doesntfazer/CrowBoard/README.md

# Crowboard
crowboard
 Single Board 34/36 Key Keyboard

Check out [Docs](https://github.com/doesntfazer/CrowBoard/tree/main/Docs) for build instructions
