doesntfazer/CrowBoard/Crowboard-Kicad-rev1 - MX - Kailh-hotswap/README.md

# Crowboard Rev1 MX
This board is tested and working
Crowboard MX
