doesntfazer/CrowBoard/Crowboard-Kicad-rev2 MX/README.md

# Crowboard Rev 2

This board isn't tested. Choc only. In theory everything should work, and the [firmware](https://github.com/doesntfazer/Keyboard-Dweebs-Firmware-repository/tree/main/KMK/CrowBoard) is made to support this board.
