doesntfazer/CrowBoard/DXF/topplate.dxf

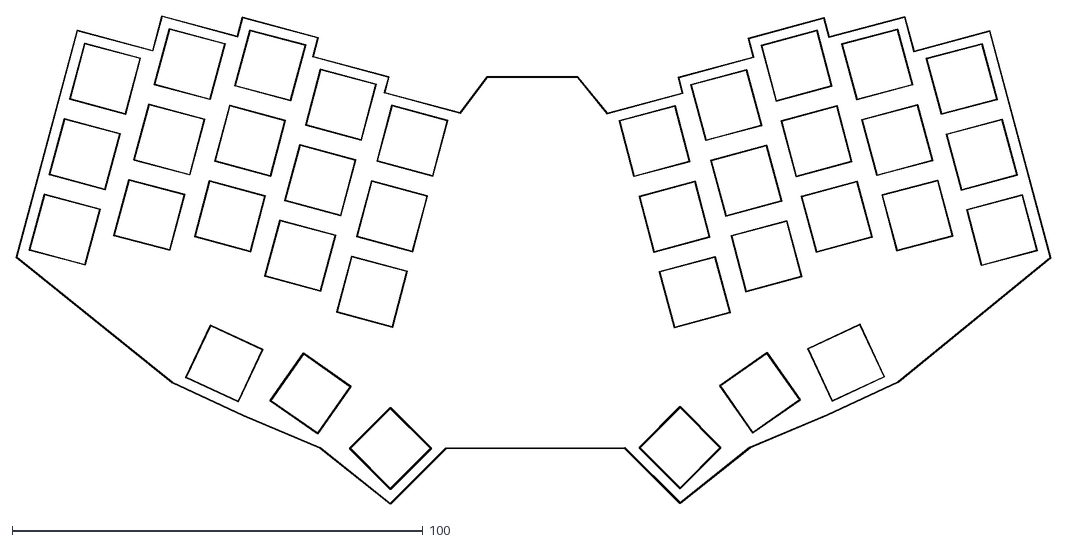
[picture p1: CAD file, 2022-05-02]
DXF/topplate.dxf
251.9 x 118.9
