doesntfazer/CrowBoard/DXF/case_BottomPlate.dxf

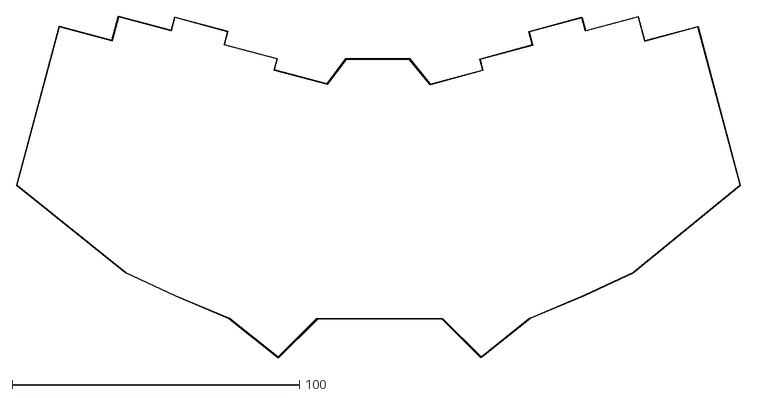
[picture p2: CAD file, 2022-05-02]
DXF/case_BottomPlate.dxf
251.9 x 118.9
