doesntfazer/CrowBoard/Case/Crowboard Bottom - friction - no screws.stl

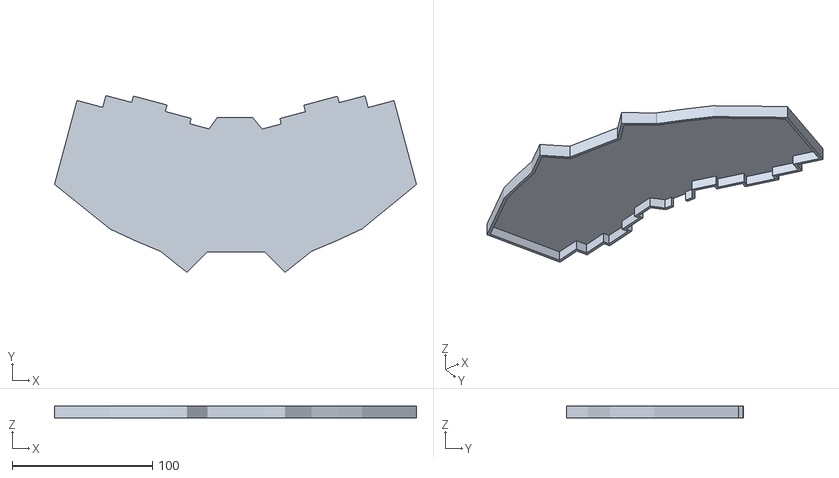
[picture p3: CAD file, 2022-06-01]
Case/Crowboard Bottom - friction - no screws.stl
258.5 x 126.3 x 8.50
