doesntfazer/CrowBoard/Case/crowboard case - friction - No screws.stl

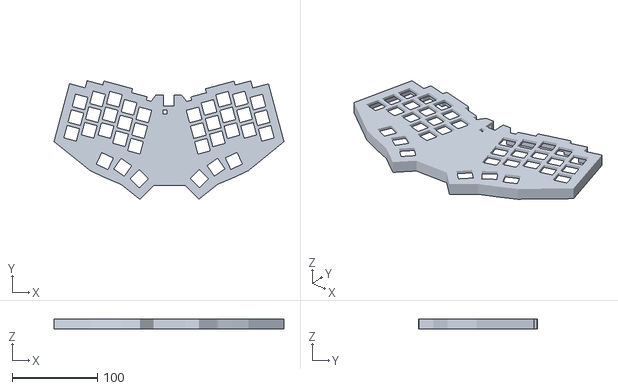
[picture p4: CAD file, 2022-06-01]
Case/crowboard case - friction - No screws.stl
269.9 x 139.2 x 11.5
