doesntfazer/CrowBoard/(commit log)

2022-04-19 fix routing
    [crowboard-B_Cu.gbl, crowboard-B_Mask.gbs, crowboard-B_Paste.gbp, crowboard-B_Silkscreen.gbo, crowboard-Edge_Cuts.gm1, crowboard-F_Cu.gtl, crowboard-F_Mask.gts, crowboard-F_Paste.gtp]
2022-04-20 switch options
2022-04-29 renamed folder
    [crowboard.kicad_pcb, crowboard.kicad_sch]
2022-05-02 MX Version
    [crowboard.kicad_pcb, crowboard.kicad_sch]
2022-05-02 move gbr
    [crowboard-B_Cu.gbl, crowboard-B_Mask.gbs, crowboard-B_Paste.gbp, crowboard-B_Silkscreen.gbo, crowboard-Edge_Cuts.gm1, crowboard-F_Cu.gtl, crowboard-F_Mask.gts, crowboard-F_Paste.gtp]
2022-05-02 mx gerber
    [crowboard-B_Cu.gbl, crowboard-B_Mask.gbs, crowboard-B_Paste.gbp, crowboard-B_Silkscreen.gbo, crowboard-Edge_Cuts.gm1, crowboard-F_Cu.gtl, crowboard-F_Mask.gts, crowboard-F_Paste.gtp]
2022-05-12 Removed Pimoroni Trackball
    [crowboard.kicad_pcb, crowboard.kicad_sch]
2022-05-15 Crowboard Rev 2 MX
    [crowboard.kicad_pcb, crowboard.kicad_sch]
2022-05-15 removed backup files
    removed
    [crowboard.kicad_pcb]
2022-05-15 fix naming convention
    [crowboard-B_Cu.gbl, crowboard-B_Mask.gbs, crowboard-B_Paste.gbp, crowboard-B_Silkscreen.gbo, crowboard-Edge_Cuts.gm1, crowboard-F_Cu.gtl, crowboard-F_Mask.gts, crowboard-F_Paste.gtp]
2022-05-15 4 encoders
    [crowboard.kicad_pcb, crowboard.kicad_sch]
2022-05-16 rename rev to rev1 choc
    [crowboard-B_Cu.gbl, crowboard-B_Mask.gbs, crowboard-B_Paste.gbp, crowboard-B_Silkscreen.gbo, crowboard-Edge_Cuts.gm1, crowboard-F_Cu.gtl, crowboard-F_Mask.gts, crowboard-F_Paste.gtp]
2022-06-01 added case files
    [Crowboard Bottom - friction - no screws.stl, crowboard case - friction - No screws.stl]
2023-02-24 Made a hot-swappable version
    Just for you wusarhu
    [crowboard-B_Cu.gbl, crowboard-B_Mask.gbs, crowboard-B_Paste.gbp, crowboard-B_Silkscreen.gbo, crowboard-Edge_Cuts.gm1, crowboard-F_Cu.gtl, crowboard-F_Mask.gts, crowboard-F_Paste.gtp]
